SumoRobotLeague/OnlineResourceLibrary_20171013/README.md

# OnlineResourceLibrary_20171013
Uploading the online resource library for users unable to access google drive
