SumoRobotLeague/OnlineResourceLibrary_20171013/3D Files Playground/MRK-1 specific/Lid R13 fromAssembly R2.stl

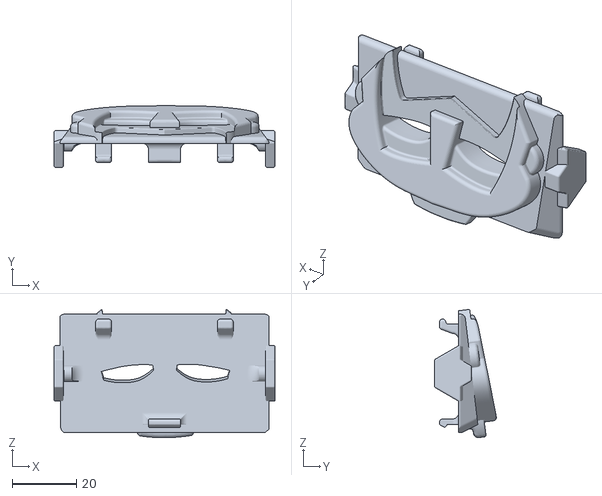
[picture p52: CAD file, 2017-10-13]
3D Files Playground/MRK-1 specific/Lid R13 fromAssembly R2.stl
69.0 x 19.3 x 40.0
