SumoRobotLeague/OnlineResourceLibrary_20171013/3D Files Playground/Lid Girl R12 from Assembly.stl

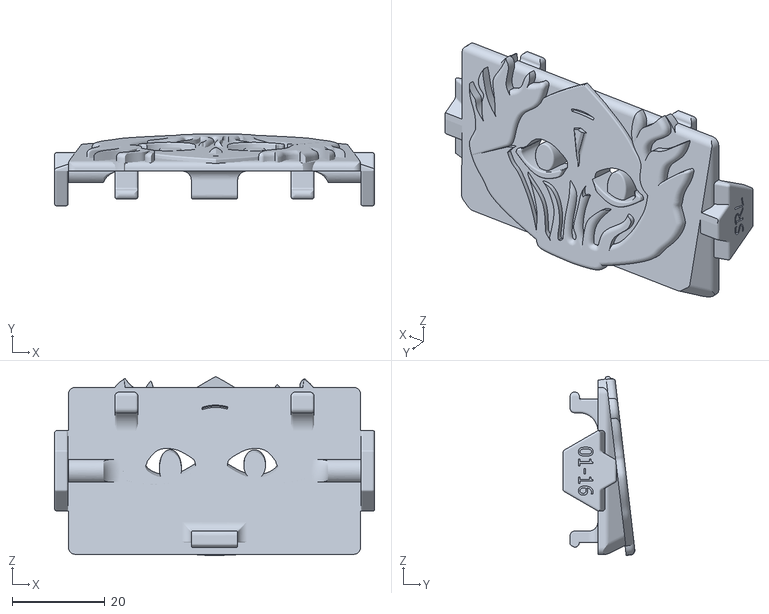
[picture p53: CAD file, 2017-10-13]
3D Files Playground/Lid Girl R12 from Assembly.stl
69.0 x 15.5 x 38.6
