SumoRobotLeague/OnlineResourceLibrary_20171013/3D Files Playground/Complete Set _3D Print Friendly _MRK-1/optional_Lid flat.stl

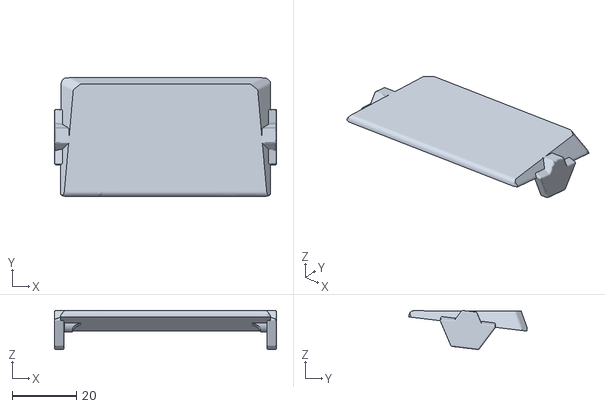
[picture p54: CAD file, 2018-06-08]
3D Files Playground/Complete Set _3D Print Friendly _MRK-1/optional_Lid flat.stl
69.0 x 36.9 x 12.1
