SumoRobotLeague/OnlineResourceLibrary_20171013/3D Files Playground/Complete Set _Injection molded _MRK-2/x1_MRK2_Lid.stl

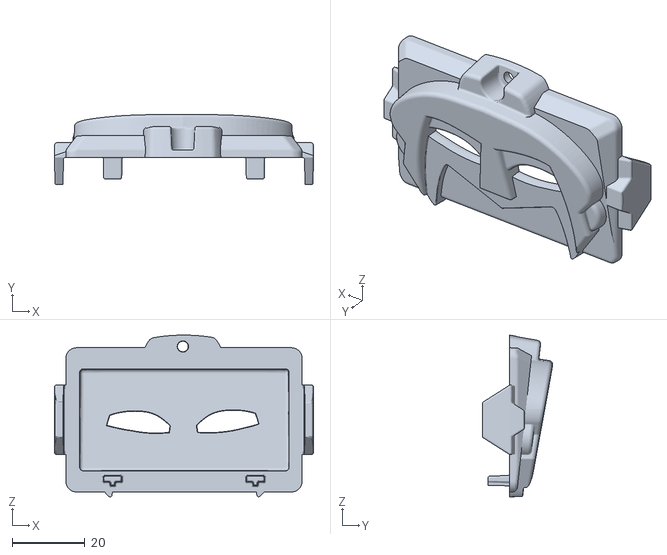
[picture p55: CAD file, 2018-03-13]
3D Files Playground/Complete Set _Injection molded _MRK-2/x1_MRK2_Lid.stl
71.1 x 19.3 x 44.4
