SumoRobotLeague/OnlineResourceLibrary_20171013/3D Files Playground/MRK-1 specific/Lid R13 flat.stl

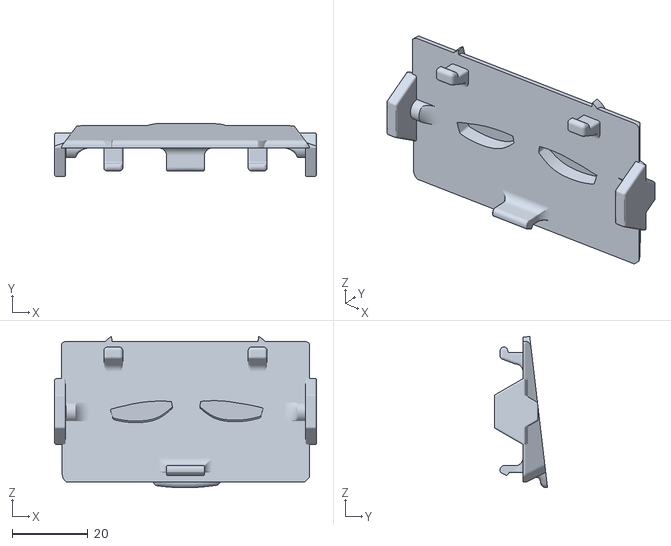
[picture p56: CAD file, 2017-10-13]
3D Files Playground/MRK-1 specific/Lid R13 flat.stl
69.0 x 14.0 x 39.8
