SumoRobotLeague/OnlineResourceLibrary_20171013/3D Files Playground/MRK-1 Strawberry Battery Box.stl

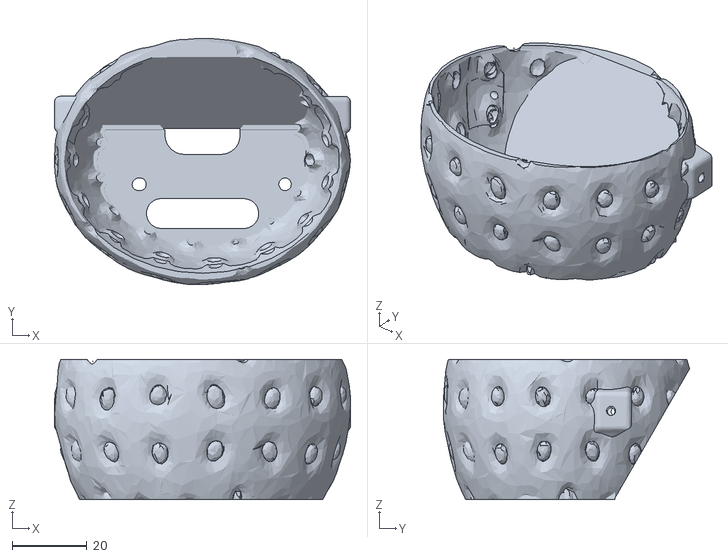
[picture p57: CAD file, 2017-10-13]
3D Files Playground/MRK-1 Strawberry Battery Box.stl
79.0 x 65.7 x 37.5
