SumoRobotLeague/OnlineResourceLibrary_20171013/3D Files Playground/Complete Set _3D Print Friendly _MRK-1/x1_LidNoHooks.stl

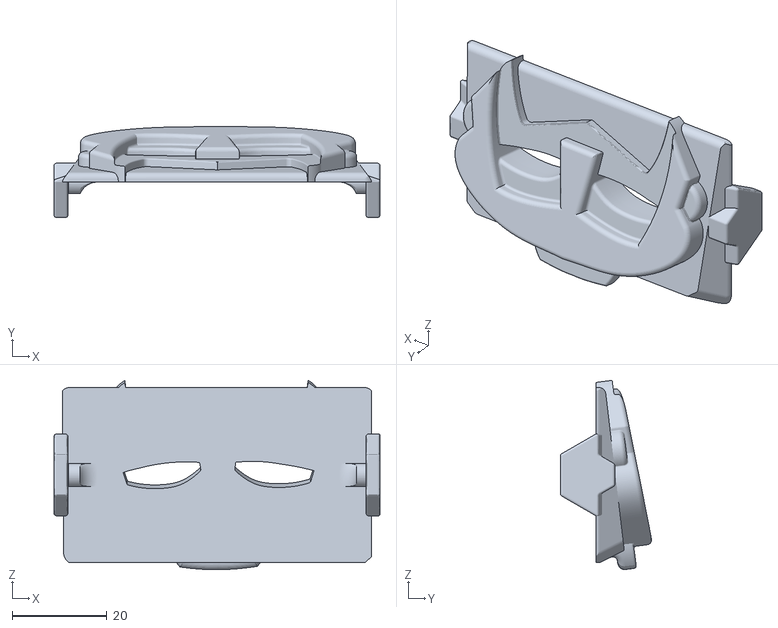
[picture p58: CAD file, 2018-06-08]
3D Files Playground/Complete Set _3D Print Friendly _MRK-1/x1_LidNoHooks.stl
69.0 x 19.3 x 40.0
