SumoRobotLeague/OnlineResourceLibrary_20171013/3D Files Playground/Complete Set _Injection molded _MRK-2/x1_MRK2_Chassis.stl

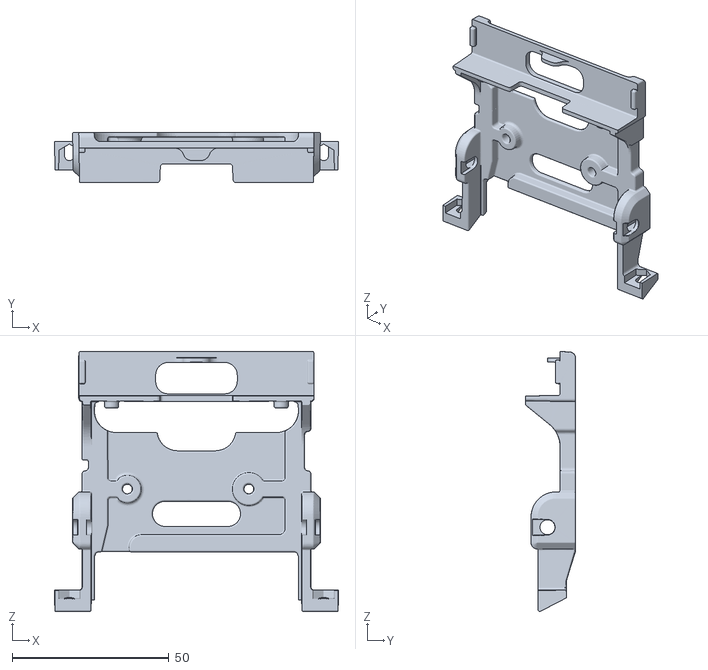
[picture p59: CAD file, 2018-03-13]
3D Files Playground/Complete Set _Injection molded _MRK-2/x1_MRK2_Chassis.stl
90.5 x 16.1 x 82.8
