SumoRobotLeague/OnlineResourceLibrary_20171013/3D Files Playground/MRK-1 Strawberry Battery Lid.stl

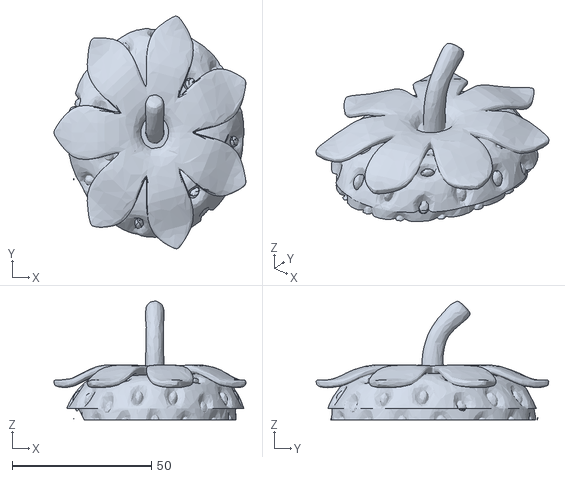
[picture p60: CAD file, 2017-10-13]
3D Files Playground/MRK-1 Strawberry Battery Lid.stl
68.9 x 83.5 x 42.6
