SumoRobotLeague/OnlineResourceLibrary_20171013/3D Files Playground/Complete Set _3D Print Friendly _MRK-1/x1_FingerGuard_r1.stl

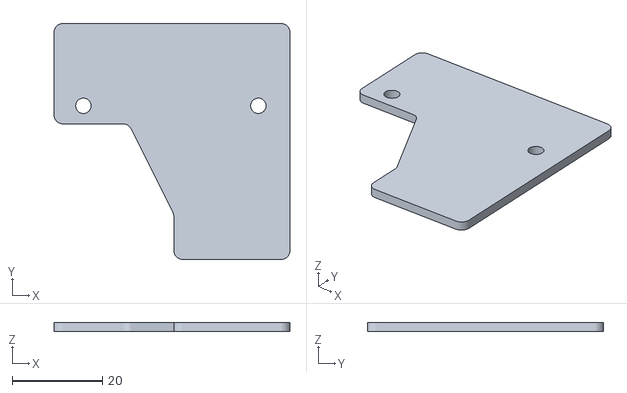
[picture p61: CAD file, 2017-10-13]
3D Files Playground/Complete Set _3D Print Friendly _MRK-1/x1_FingerGuard_r1.stl
52.2 x 52.2 x 2.00
