SumoRobotLeague/OnlineResourceLibrary_20171013/3D Files Playground/Complete Set _Injection molded _MRK-2/x1_MRK2_BatteryBox.stl

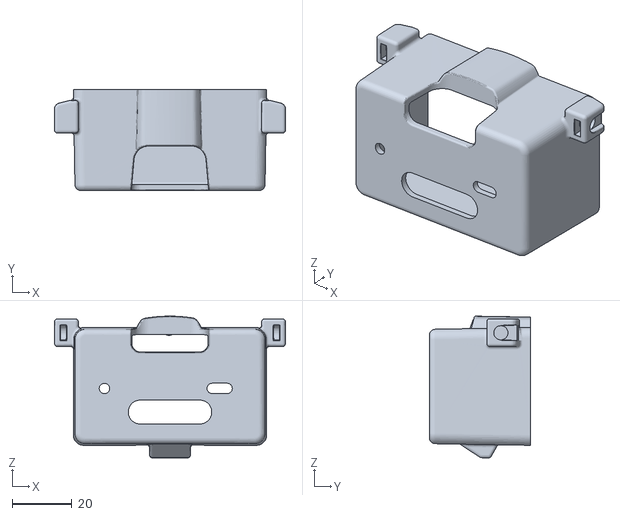
[picture p62: CAD file, 2018-03-13]
3D Files Playground/Complete Set _Injection molded _MRK-2/x1_MRK2_BatteryBox.stl
77.6 x 34.0 x 47.6
