SumoRobotLeague/OnlineResourceLibrary_20171013/3D Files Playground/Complete Set _3D Print Friendly _MRK-1/x2_Wheel for motor rev4 added0_2mmDiam.stl

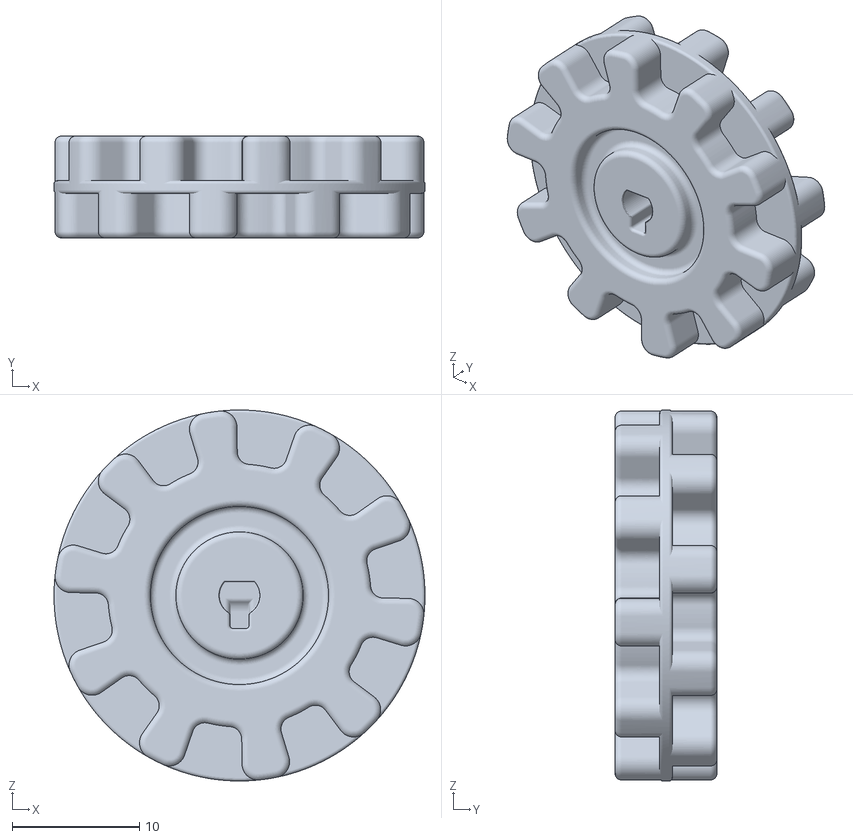
[picture p63: CAD file, 2017-10-13]
3D Files Playground/Complete Set _3D Print Friendly _MRK-1/x2_Wheel for motor rev4 added0_2mmDiam.stl
29.2 x 8.00 x 29.2
