SumoRobotLeague/OnlineResourceLibrary_20171013/3D Files Playground/Complete Set _Injection molded _MRK-2/x1_MRK2_scoop.stl

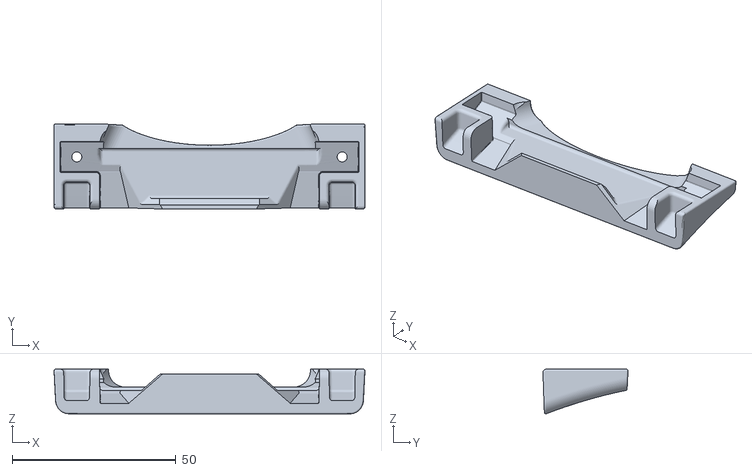
[picture p64: CAD file, 2018-03-13]
3D Files Playground/Complete Set _Injection molded _MRK-2/x1_MRK2_scoop.stl
94.9 x 26.0 x 13.6
