SumoRobotLeague/OnlineResourceLibrary_20171013/3D Files Playground/Lid_vader.stl

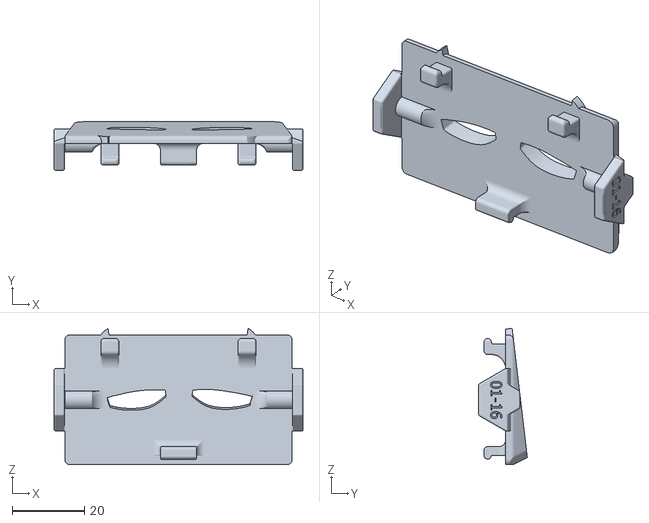
[picture p65: CAD file, 2017-10-13]
3D Files Playground/Lid_vader.stl
69.0 x 13.5 x 37.8
