SumoRobotLeague/OnlineResourceLibrary_20171013/3D Files Playground/Complete Set _3D Print Friendly _MRK-1/optional_ThirdWheel_reduced_3pt5diam.stl

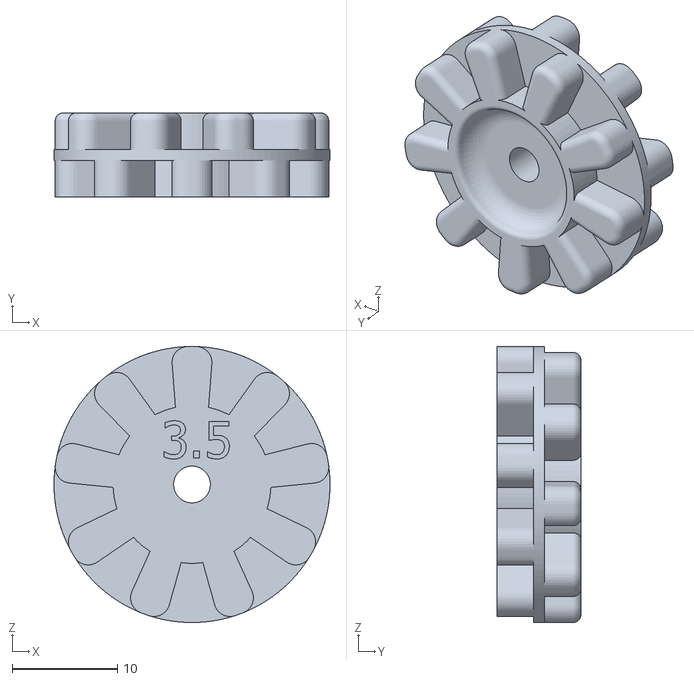
[picture p66: CAD file, 2017-10-13]
3D Files Playground/Complete Set _3D Print Friendly _MRK-1/optional_ThirdWheel_reduced_3pt5diam.stl
26.2 x 8.00 x 26.2
