SumoRobotLeague/OnlineResourceLibrary_20171013/3D Files Playground/Complete Set _Injection molded _MRK-2/x1_MRK2_motorCover.stl

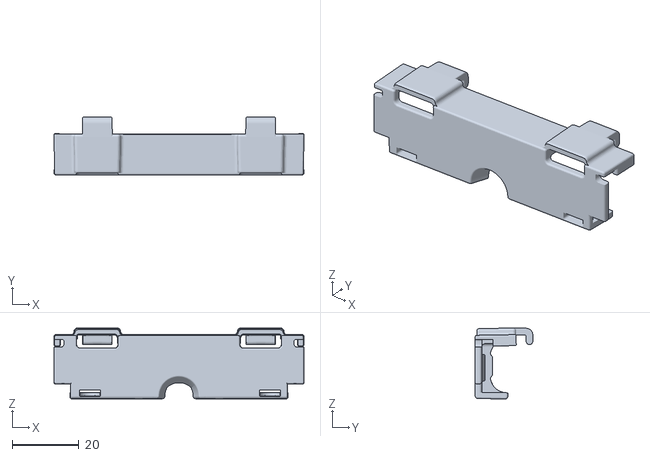
[picture p67: CAD file, 2018-03-13]
3D Files Playground/Complete Set _Injection molded _MRK-2/x1_MRK2_motorCover.stl
75.0 x 17.3 x 21.3
