SumoRobotLeague/OnlineResourceLibrary_20171013/3D Files Playground/Sumo Mask from Lid R5faceOnly.stl

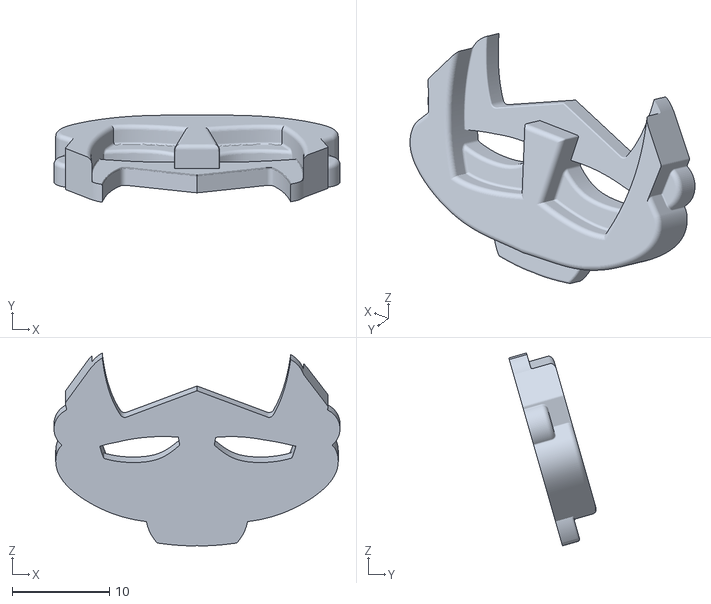
[picture p68: CAD file, 2017-10-13]
3D Files Playground/Sumo Mask from Lid R5faceOnly.stl
29.4 x 9.01 x 19.8
