SumoRobotLeague/OnlineResourceLibrary_20171013/3D Files Playground/Complete Set _3D Print Friendly _MRK-1/x1_Chassis R13.stl

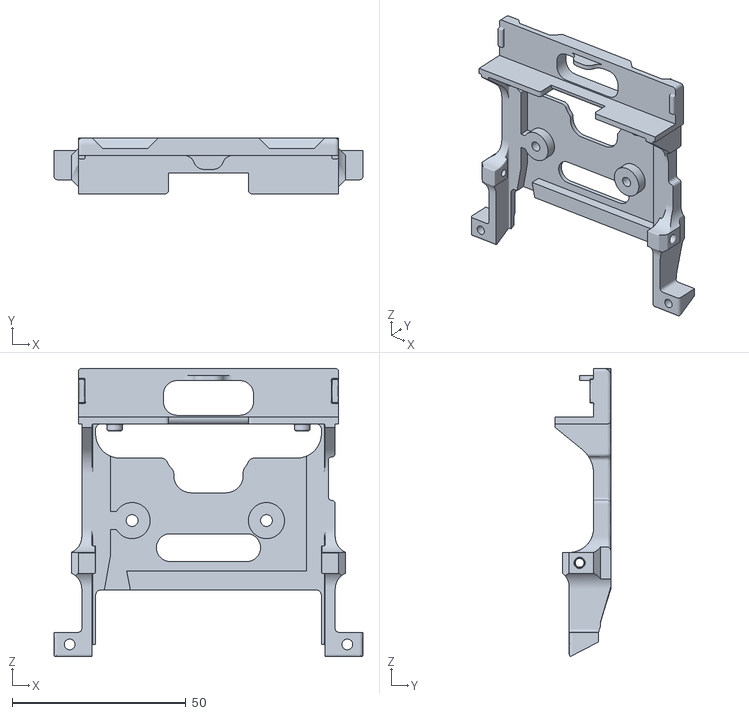
[picture p69: CAD file, 2017-10-13]
3D Files Playground/Complete Set _3D Print Friendly _MRK-1/x1_Chassis R13.stl
89.0 x 16.1 x 83.0
