SumoRobotLeague/OnlineResourceLibrary_20171013/3D Files Playground/Complete Set _3D Print Friendly _MRK-1/x1_Scoop R11.stl

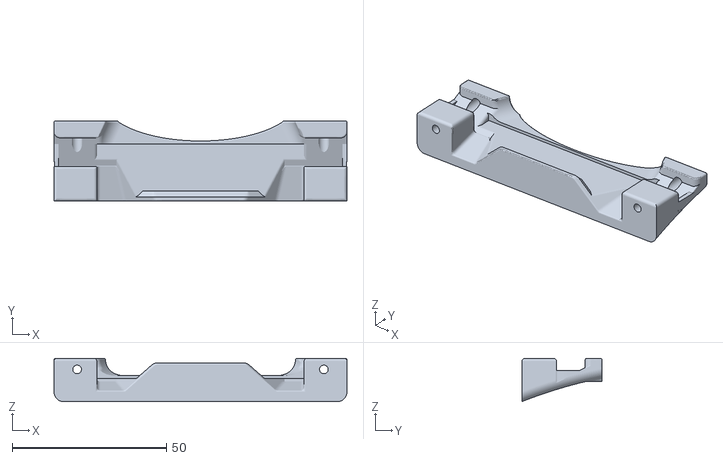
[picture p70: CAD file, 2017-10-13]
3D Files Playground/Complete Set _3D Print Friendly _MRK-1/x1_Scoop R11.stl
95.0 x 26.0 x 14.0
