SumoRobotLeague/OnlineResourceLibrary_20171013/3D Files Playground/Complete Set _3D Print Friendly _MRK-1/x1_BatteryBox Rev15.stl

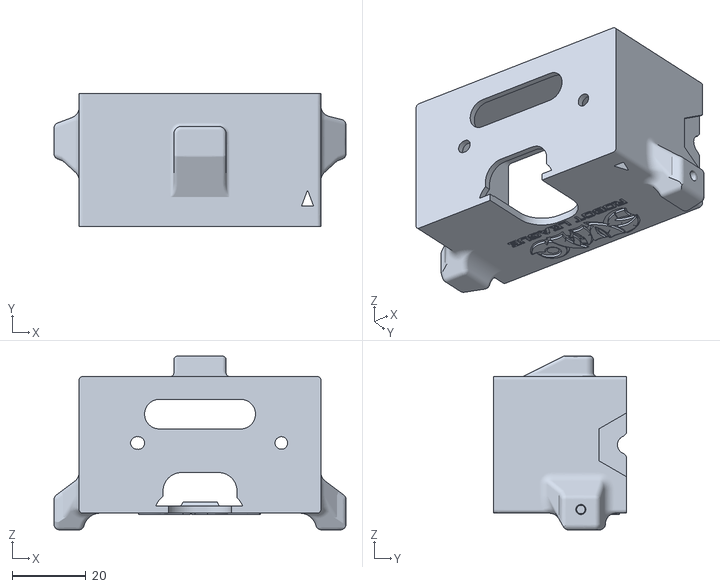
[picture p71: CAD file, 2017-10-13]
3D Files Playground/Complete Set _3D Print Friendly _MRK-1/x1_BatteryBox Rev15.stl
79.0 x 36.1 x 47.0
