SumoRobotLeague/OnlineResourceLibrary_20171013/(list of files, cad)

Other CAD files:
3D Files Playground/Complete Set _3D Print Friendly _MRK-1/x1_Motor Cover R11.stl
3D Files Playground/Complete Set _3D Print Friendly _MRK-1/optional_ThirdWheel_reduced_3pt8diam.stl
3D Files Playground/Complete Set _3D Print Friendly _MRK-1/optional_Wheel for screw rev5 _radius1pt75mm.stl
3D Files Playground/Complete Set _3D Print Friendly _MRK-1/x4_Wheel for screw rev5 _added0_7mmdiam.stl
3D Files Playground/Complete Set _Injection molded _MRK-2/x4_Wheel for screw rev5 _added0_7mmdiam.stl
