SumoRobotLeague/OnlineResourceLibrary_20171013/(commit log)

2017-10-13 Upload of the Resource Library
    [BatteryBox Rev15.stl, Chassis R13.stl, FingerGuard_r1.stl, Lid Girl R12 from Assembly.stl, Lid R13 flat.stl, Lid R13 fromAssembly R2.stl, Lid_vader.stl, MRK-1 Strawberry Battery Box.stl]
2018-02-19 Adds MRK-2 Assembly Insert
2018-03-13 Uploading some MRK2 3D files
    [MRK2_BatteryBox.stl, MRK2_Chassis.stl, MRK2_Lid.stl, MRK2_scoop.stl]
2018-03-13 Another MRK2 3D file
    These 3D files are not optomized for 3D printing but were created for
    making injection-molded parts
    [MRK2_motorCover.stl]
2018-06-08 Organizational improvement
    The 3D playground is now organized into a 3D printer friendly set of
    parts and an injection molded compatible set of parts depending on your
    needs.
    [Lid Girl R12 from Assembly.stl, Lid R13 flat.stl, Lid R13 fromAssembly R2.stl, Lid_vader.stl, optional_Lid flat.stl, optional_ThirdWheel_reduced_3pt5diam.stl, optional_ThirdWheel_reduced_3pt8diam.stl, optional_Wheel for screw rev5 _radius1pt75mm.stl]
2018-06-08 Guidelines and tips for 3D printing robot parts
2018-06-11 Some assembly instructions
    These instructions are for those who buy electronics and print their own
    3D parts.
